rkrajnc/minimig-upstream/README.md

Follows upstream (original) minimig project.
