rkrajnc/minimig-upstream/OTHER/minimig1_layout.pdf

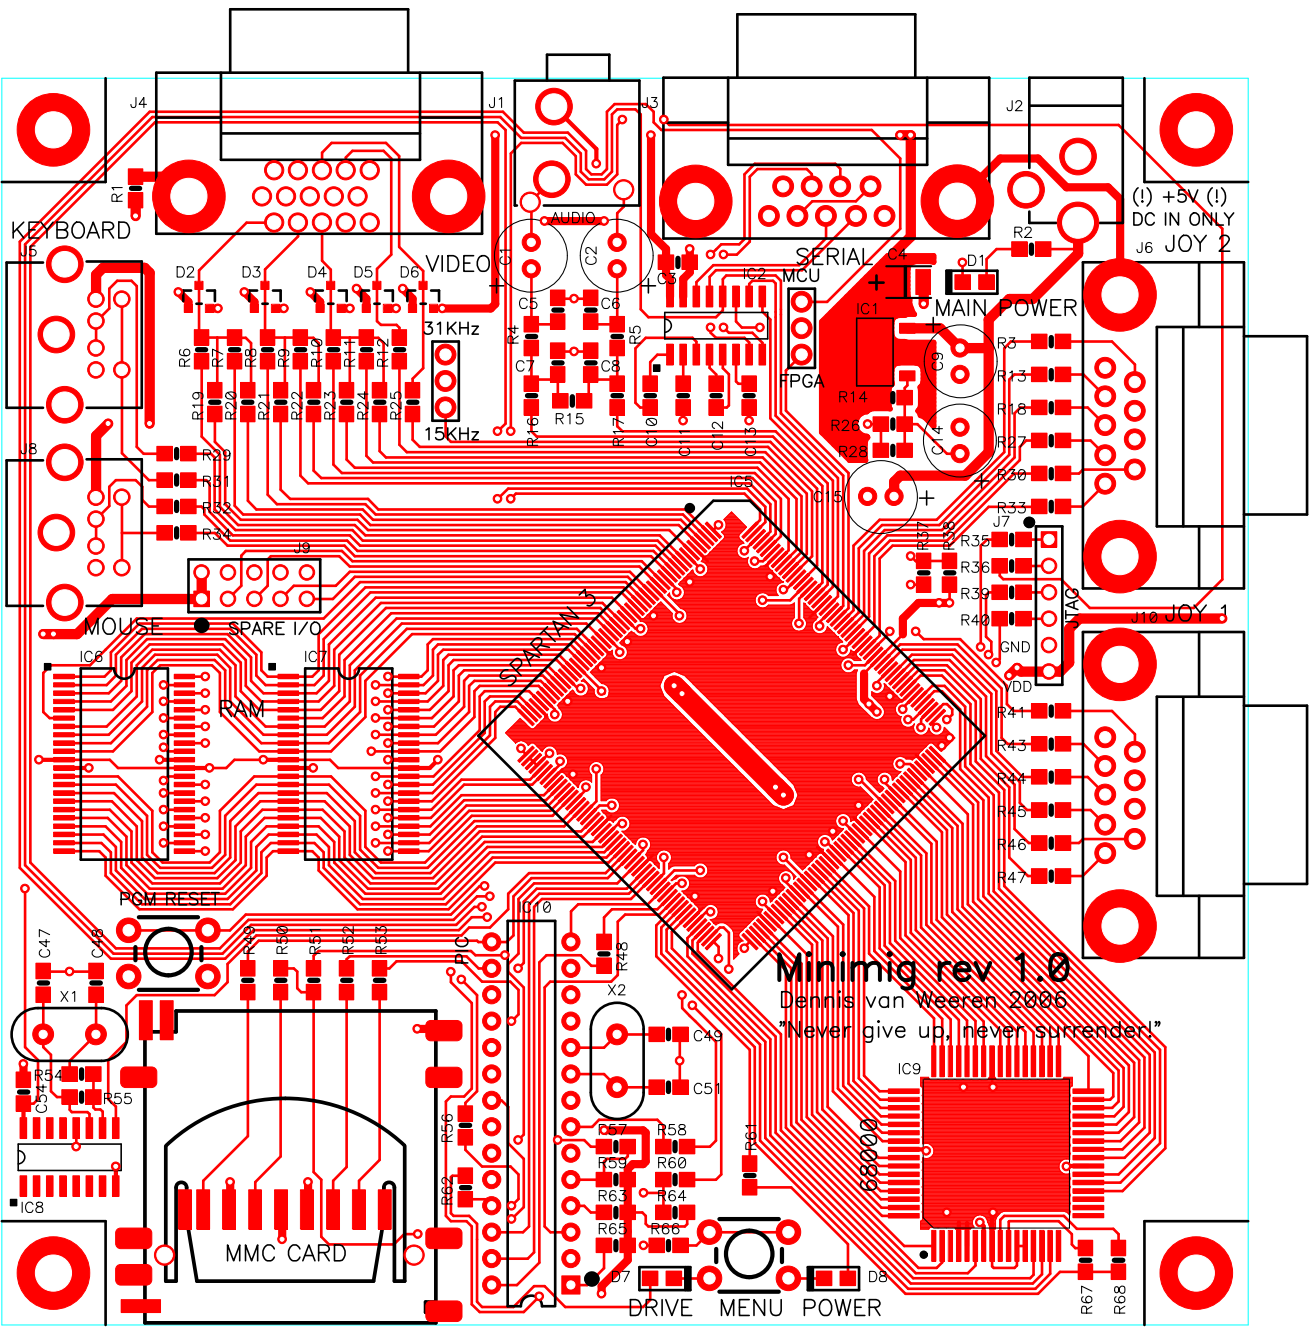
[picture p4: page 1]

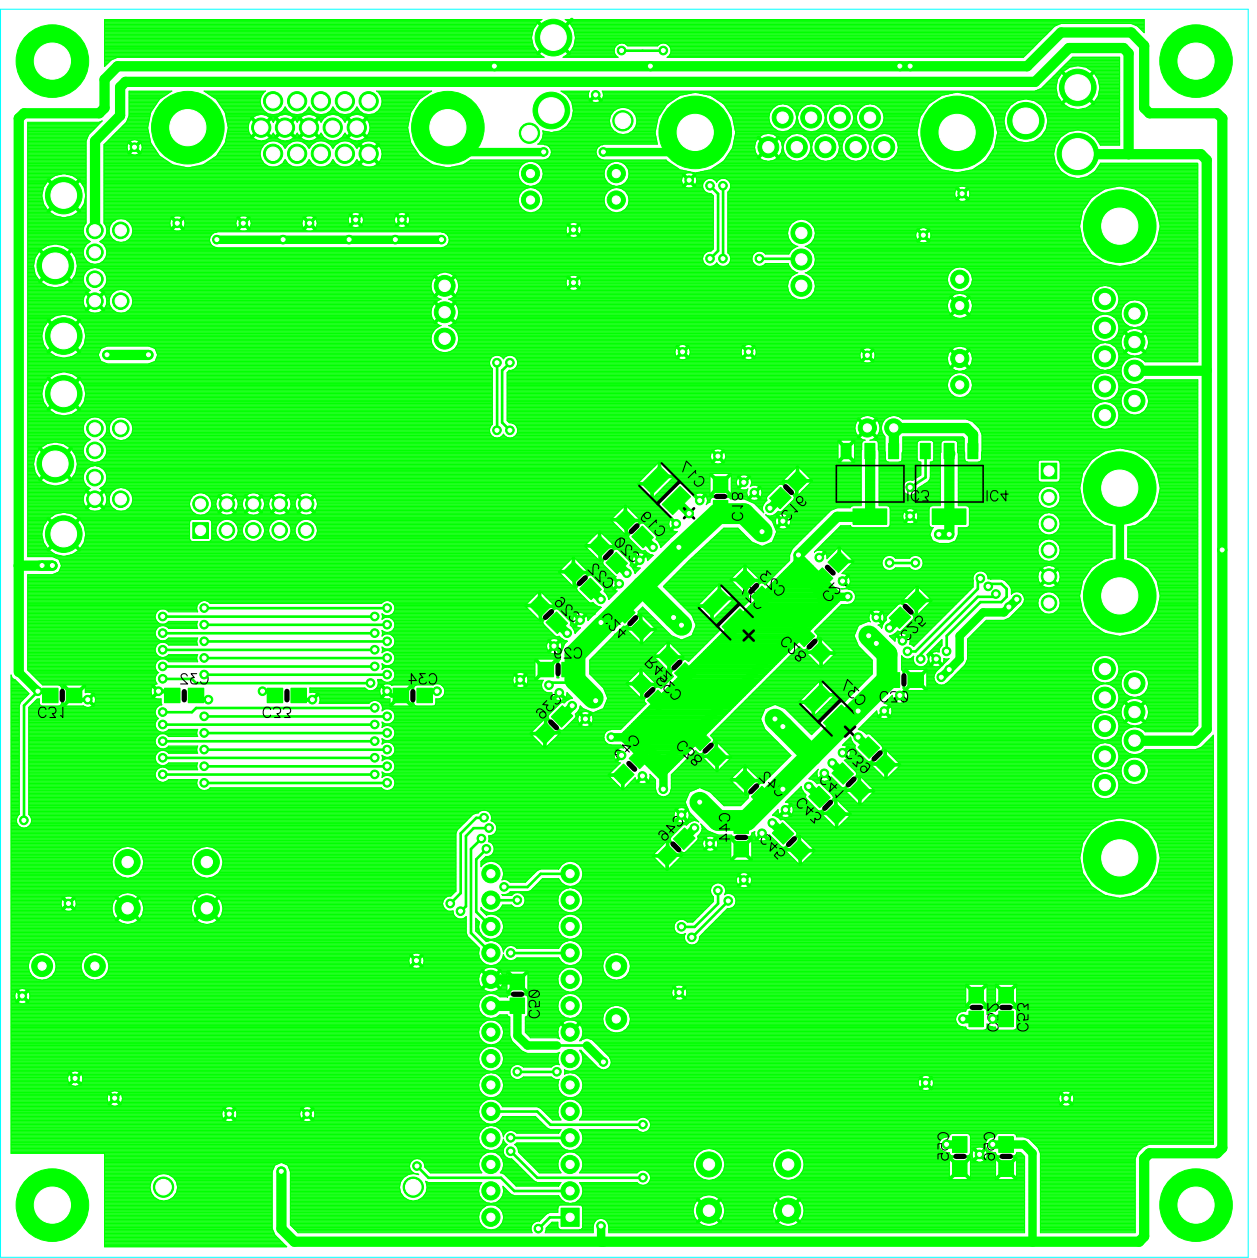
[picture p5: page 2]
