rkrajnc/minimig-upstream/FPGA/Floppy.v

// Copyright 2006, 2007 Dennis van Weeren
//
// This file is part of Minimig
//
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
//
//
// This is the floppy disk controller (part of Paula)
//
// 23-10-2005	-started coding
// 24-10-2005	-done lots of work
// 13-11-2005	-modified fifo to use block ram
//				-done lots of work
// 14-11-2005	-done more work
// 19-11-2005	-added wordsync logic
// 20-11-2005	-finished core floppy disk interface
//				-added disk interrupts
//				-added floppy control signal emulation
// 21-11-2005	-cleaned up code a bit
// 27-11-2005	-den and sden are now active low (_den and _sden)
//				-fixed bug in parallel/serial converter
//				-fixed more bugs
// 02-12-2005	-removed dma abort function
// 04-12-2005	-fixed bug in fifo empty signalling
// 09-12-2005	-fixed dsksync handling	
//				-added protection against stepping beyond track limits
// 10-12-2005	-fixed some more bugs
// 11-12-2005	-added dout output enable to allow SPI bus multiplexing
// 12-12-2005	-fixed major bug, due error in statemachine, multiple interrupts were requested
//				 after a DMA transfer, this could lock up the whole machine
// 				-enable line disconnected  --> this module still needs a lot of work
// 27-12-2005	-cleaned up code, this is it for now
// 07-01-2005	-added dmas
// 15-01-2006	-added support for track 80-127 (used for loading kickstart)
// 22-01-2006	-removed support for track 80-127 again
// 06-02-2006	-added user disk control input
// 28-12-2006	-spi data out is now low when not addressed to allow multiplexing with multiple spi devices		
//
// JB:
// 2008-07-17	- modified floppy interface for better read handling and write support
//				- spi interface clocked by SPI clock
// 2008-09-24	- incompatibility found: _READY signal should respond to _SELx even when the motor is off
//				- added logic for four floppy drives
// 2008-10-07	- ide command request implementation
// 2008-10-28	- further hdd implementation
// 2009-04-05	- code clean-up
// 2009-05-24	- clean-up & renaming
// 2009-07-21	- WORDEQUAL in DSKBYTR register is always set now
// 2009-11-14	- changed DSKSYNC reset value (Kick 1.3 doesn't initialize this register after reset)
//				- reduced FIFO size (to save some block rams)
// 2009-12-26	- step enable
// 2010-04-12	- implemented work-around for dsksync interrupt request
// 2010-08-14	- set BYTEREADY of DSKBYTR (required by Kick Off 2 loader)

module floppy
(
	// system bus interface
	input 	clk,		    		// bus clock
	input 	reset,			   		// reset
	input	ntsc,					// ntsc mode
	input	sof,					// start of frame
	input	enable,					// dma enable
	input 	[8:1] reg_address_in,	// register address inputs
	input	[15:0] data_in,			// bus data in
	output	[15:0] data_out,		// bus data out
	output	dmal,					// dma request output
	output	dmas,					// dma special output 
	// disk control signals from cia and user
	input	_step,					// step heads of disk
	input	direc,					// step heads direction
	input	[3:0] _sel,				// disk select 	
	input	side,					// upper/lower disk head
	input	_motor,					// disk motor control
	output	_track0,				// track zero detect
	output	_change,				// disk has been removed from drive
	output	_ready,					// disk is ready
	output	_wprot,					// disk is write-protected
	output	index,					// disk index pulse
	// interrupt request and misc. control
	output	reg blckint,			// disk dma has finished interrupt
	output	syncint,				// disk syncword found
	input	wordsync,				// wordsync enable
	// flash drive host controller interface	(SPI)
	input	_scs,					// async. serial data enable
	input	sdi,					// async. serial data input
	output	sdo,					// async. serial data output
	input	sck,					// async. serial data clock
	
	output	disk_led,				// disk activity LED, active when DMA is on
	input	[1:0] floppy_drives,	// floppy drive number
	
	input	direct_scs,				// enables direct data transfer from SD card
	input	direct_sdi,				// data line from SD card
	input	hdd_cmd_req,			// HDD requests service (command register has been written)
	input	hdd_dat_req,			// HDD requests data tansfer
	output	[2:0] hdd_addr,			// task file register address
	output	[15:0] hdd_data_out,	// data from HDD to HDC
	input	[15:0] hdd_data_in,		// data from HDC to HDD
	output	hdd_wr,					// task file register write strobe
	output	hdd_status_wr,			// status register write strobe (MCU->HDD)
	output	hdd_data_wr,			// data write strobe
	output	hdd_data_rd				// data read strobe
);

//register names and addresses
	parameter DSKBYTR = 9'h01a;
	parameter DSKDAT  = 9'h026;
	parameter DSKDATR = 9'h008;
	parameter DSKSYNC = 9'h07e;
	parameter DSKLEN  = 9'h024;

	//local signals
	reg		[15:0] dsksync;			//disk sync register
	reg		[15:0] dsklen;			//disk dma length, direction and enable 
	reg		[6:0] dsktrack [3:0];	//track select
	wire	[7:0] track;

	reg		dmaon;					//disk dma read/write enabled
	wire	lenzero;				//disk length counter is zero
	wire	spidat;					//spi data word transfer strobe
	reg		trackwr;				//write track (command to host)
	reg		trackrd;				//read track (command to host)

	wire	_dsktrack0;				//disk heads are over track 0
	wire	dsktrack79;				//disk heads are over track 0

	wire	[15:0] fifo_in;			//fifo data in
	wire	[15:0] fifo_out; 		//fifo data out
	wire	fifo_wr;				//fifo write enable
	reg		fifo_wr_del;			//fifo write enable delayed
	wire	fifo_rd;				//fifo read enable
	wire	fifo_empty;				//fifo is empty
	wire	fifo_full;				//fifo is full
	wire	[11:0] fifo_cnt;

	wire	[15:0] dskbytr;
	wire	[15:0] dskdatr;

	// JB:
	wire	fifo_reset;
	reg		dmaen;					//dsklen dma enable
	reg		[15:0] wr_fifo_status;

	reg		[3:0] disk_present;		//disk present status
	reg		[3:0] disk_writable;	//disk write access status

	wire	_selx;					//active whenever any drive is selected
	wire	[1:0] sel;				//selected drive number

	reg		[1:0] drives;			//number of currently connected floppy drives (1-4)

	reg		[3:0] _disk_change;
	reg		_step_del;
	reg		[8:0] step_ena_cnt;
	wire	step_ena;
	// drive motor control
	reg		[3:0] _sel_del;			// deleyed drive select signals for edge detection
	reg		[3:0] motor_on;			// drive motor on

	//decoded SPI commands
	reg		cmd_fdd;				//SPI host accesses floppy drive buffer
	reg		cmd_hdd_rd;				//SPI host reads task file registers		
	reg		cmd_hdd_wr;				//SPI host writes task file registers
	reg		cmd_hdd_data_wr;		//SPI host writes data to HDD buffer
	reg		cmd_hdd_data_rd;		//SPI host reads data from HDD buffer

//-----------------------------------------------------------------------------------------------//
// JB: SPI interface
//-----------------------------------------------------------------------------------------------//

	wire sdin;					//SPI data in
	wire scs;					//SPI chip select
	wire scs1;
	wire scs2;

	reg [3:0] spi_bit_cnt;		//received bit counter - incremented on rising edge of SCK
	wire spi_bit_15;
	wire spi_bit_0;
	reg [15:1] spi_sdi_reg;		//spi receive register
	reg [15:0] rx_data;			//spi received data
	reg [15:0] spi_sdo_reg;		//spi transmit register (shifted on SCK falling edge)

	reg spi_rx_flag;
	reg rx_flag_sync;
	reg rx_flag;
	wire spi_rx_flag_clr;

	reg spi_tx_flag;
	reg tx_flag_sync;
	reg tx_flag;
	wire spi_tx_flag_clr;

	reg [15:0] spi_tx_data;		//data to be send via SPI
	reg [15:0] spi_tx_data_0;
	reg [15:0] spi_tx_data_1;
	reg [15:0] spi_tx_data_2;
	reg [15:0] spi_tx_data_3;

	reg [1:0] spi_tx_cnt;		//transmitted SPI words counter
	reg [1:0] spi_tx_cnt_del;	//delayed transmitted SPI words counter
	reg [1:0] tx_cnt;			//transmitted SPI words counter
	reg	[2:0] tx_data_cnt;
	reg	[2:0] rx_data_cnt;

	reg	[1:0] rx_cnt;
	reg	[1:0] spi_rx_cnt;		//received SPI words counter (counts form 0 to 3 and stops there)
	reg	spi_rx_cnt_rst;			//indicates reception of the first spi word after activation of the chip select

//SPI mode 0 - high idle clock
assign sdin = direct_scs ? direct_sdi : sdi;
assign scs1 = ~_scs;
assign scs2 = direct_scs;
assign scs = scs1 | scs2;

//received bits counter (0-15)
always @(posedge sck or negedge scs)
	if (~scs)
		spi_bit_cnt <= 0; //reset if chip select is not active
	else
		spi_bit_cnt <= spi_bit_cnt + 1;

assign spi_bit_15 = spi_bit_cnt==15 ? 1 : 0;
assign spi_bit_0 = spi_bit_cnt==0 ? 1 : 0;

//SDI input shift register
always @(posedge sck)
	spi_sdi_reg <= {spi_sdi_reg[14:1],sdin};

//spi rx data register
always @(posedge sck)
	if (spi_bit_15)
		rx_data <= {spi_sdi_reg[15:1],sdin};

// rx_flag is synchronous with clk and is set after receiving the last bit of a word
assign spi_rx_flag_clr = rx_flag | reset;
always @(posedge sck or posedge spi_rx_flag_clr)
	if (spi_rx_flag_clr)
		spi_rx_flag <= 0;
	else if (spi_bit_cnt==15)
		spi_rx_flag <= 1;

always @(negedge clk)
	rx_flag_sync <= spi_rx_flag;	//double synchronization to avoid metastability

always @(posedge clk)
	rx_flag <= rx_flag_sync;		//synchronous with clk

// tx_flag is synchronous with clk and is set after sending the first bit of a word
assign spi_tx_flag_clr = tx_flag | reset;
always @(negedge sck or posedge spi_tx_flag_clr)
	if (spi_tx_flag_clr)
		spi_tx_flag <= 0;
	else if (spi_bit_cnt==0)
		spi_tx_flag <= 1;

always @(negedge clk)
	tx_flag_sync <= spi_tx_flag;	//double synchronization to avoid metastability

always @(posedge clk)
	tx_flag <= tx_flag_sync;		//synchronous with clk

//---------------------------------------------------------------------------------------------------------------------

always @(negedge sck or negedge scs)
	if (~scs)
		spi_tx_cnt <= 0;
	else if (spi_bit_0 && spi_tx_cnt!=3)
		spi_tx_cnt <= spi_tx_cnt + 1;

always @(negedge sck)
	if (spi_bit_0) 
		spi_tx_cnt_del <= spi_tx_cnt;

always @(posedge clk)
	tx_cnt <= spi_tx_cnt_del;

//trnsmitted words counter (0-3) used for transfer of IDE task file registers
always @(negedge sck)
	if (spi_bit_cnt==0)
		if (spi_tx_cnt==2)
			tx_data_cnt <= 0;
		else
			tx_data_cnt <= tx_data_cnt + 1;

//received data counter, used only for transferring IDE task file register contents, count range: 0-7
always @(posedge clk)
	if (rx_flag)
		if (rx_cnt != 3)
			rx_data_cnt <= 0;
		else
			rx_data_cnt <= rx_data_cnt + 1;

//HDD interface
assign hdd_addr = cmd_hdd_rd ? tx_data_cnt : cmd_hdd_wr ? rx_data_cnt : 0;
assign hdd_wr = cmd_hdd_wr && rx_flag && rx_cnt==3 ? 1 : 0;
assign hdd_data_wr = (cmd_hdd_data_wr && rx_flag && rx_cnt==3) || (scs2 && rx_flag) ? 1 : 0;	//there is a possibility that SCS2 is inactive before rx_flag is generated, depends on how fast the CS2 is deaserted after sending the last data bit
assign hdd_status_wr = rx_data[15:12]==4'b1111 && rx_flag && rx_cnt==0 ? 1 : 0;
// problem: spi_cmd1 doesn't deactivate after rising _CS line: direct transfers will be treated as command words,
// workaround: always send more than one command word
assign hdd_data_rd = cmd_hdd_data_rd && tx_flag && tx_cnt==3 ? 1 : 0;
assign hdd_data_out = rx_data[15:0];

always @(posedge sck or negedge scs1)
	if (~scs1)
		spi_rx_cnt_rst <= 1;
	else if (spi_bit_15)
		spi_rx_cnt_rst <= 0;

always @(posedge sck)
	if (scs1 && spi_bit_15)
		if (spi_rx_cnt_rst)
			spi_rx_cnt <= 0;
		else if (spi_rx_cnt!=3)
			spi_rx_cnt <= spi_rx_cnt + 1;

always @(posedge clk)
	rx_cnt <= spi_rx_cnt;

//spidat strobe
assign spidat = cmd_fdd && rx_flag && rx_cnt==3 ? 1 : 0;

//------------------------------------

//SDO output shift register
always @(negedge sck)
	if (spi_bit_cnt==0)
		spi_sdo_reg <= spi_tx_data;
	else
		spi_sdo_reg <= {spi_sdo_reg[14:0],1'b0};

assign sdo = scs1 & spi_sdo_reg[15];

//spi transmit data multiplexer
always @(spi_tx_cnt or spi_tx_data_0 or spi_tx_data_1 or spi_tx_data_2 or spi_tx_data_3)
	case (spi_tx_cnt[1:0])
		0 : spi_tx_data = spi_tx_data_0;
		1 : spi_tx_data = spi_tx_data_1;
		2 : spi_tx_data = spi_tx_data_2;
		3 : spi_tx_data = spi_tx_data_3;
	endcase

always @(sel or drives or hdd_dat_req or hdd_cmd_req or trackwr or trackrd or track or fifo_cnt)
	spi_tx_data_0 = {sel[1:0],drives[1:0],hdd_dat_req,hdd_cmd_req,trackwr,trackrd&~fifo_cnt[10],track[7:0]};

always @(dsksync)
	if (reset)
		spi_tx_data_1 = 0;
	else
		spi_tx_data_1 = dsksync[15:0];

always @(trackrd or dmaen or dsklen or trackwr or wr_fifo_status)
	if (trackrd)
		spi_tx_data_2 = {dmaen,dsklen[14:0]};
	else if (trackwr)
		spi_tx_data_2 = wr_fifo_status;
	else
		spi_tx_data_2 = 0;

always @(cmd_fdd or trackrd or dmaen or dsklen or trackwr or fifo_out or cmd_hdd_rd or cmd_hdd_data_rd or hdd_data_in)	
	if (cmd_fdd)
		if (trackrd)
			spi_tx_data_3 = {dmaen,dsklen[14:0]};
		else if (trackwr)
			spi_tx_data_3 = fifo_out;
		else
			spi_tx_data_3 = 0;
	else if (cmd_hdd_rd || cmd_hdd_data_rd)
		spi_tx_data_3 = hdd_data_in;
	else
		spi_tx_data_3 = 0;


//floppy disk write fifo status is latched when transmision of the previous spi word begins 
//it guarantees that when latching the status data into spi transmit register setup and hold times are met
always @(posedge clk)
	if (tx_flag)
		wr_fifo_status <= {dmaen&dsklen[14],3'b000,fifo_cnt[11:0]};

//-----------------------------------------------------------------------------------------------//
//active floppy drive number, updated during reset
always @(posedge clk)
	if (reset)
		drives <= floppy_drives;

//-----------------------------------------------------------------------------------------------//
// 300 RPM floppy disk rotation signal
reg [3:0] rpm_pulse_cnt;
always @(posedge clk)
	if (sof)
		if (rpm_pulse_cnt==11 || !ntsc && rpm_pulse_cnt==9)
			rpm_pulse_cnt <= 0;
		else
			rpm_pulse_cnt <= rpm_pulse_cnt + 1;

// disk index pulses output
assign index = |(~_sel & motor_on) & ~|rpm_pulse_cnt & sof;

//--------------------------------------------------------------------------------------
//data out multiplexer
assign data_out = dskbytr | dskdatr;

//--------------------------------------------------------------------------------------
//active whenever any drive is selected
assign _selx = &_sel[3:0];

// delayed step signal for detection of its rising edge	
always @(posedge clk)
	_step_del <= _step;

always @(posedge clk)
	if (!step_ena)
		step_ena_cnt <= step_ena_cnt + 1;
	else if (_step && !_step_del)
		step_ena_cnt <= 0;

assign step_ena = step_ena_cnt[8];

// disk change latch
// set by reset or when the disk is removed form the drive
// reset when the disk is present and step pulse is received for selected drive
always @(posedge clk)
	_disk_change <= (_disk_change | ~_sel & {4{_step}} & ~{4{_step_del}} & disk_present) & ~({4{reset}} | ~disk_present);

//active drive number (priority encoder)
assign sel = !_sel[0] ? 0 : !_sel[1] ? 1 : !_sel[2] ? 2 : !_sel[3] ? 3 : 0;

//delayed drive select signals
always @(posedge clk)
	_sel_del <= _sel;

//drive motor control
always @(posedge clk)
	if (reset)
		motor_on[0] <= 1'b0;
	else if (!_sel[0] && _sel_del[0])
		motor_on[0] <= ~_motor;

always @(posedge clk)
	if (reset)
		motor_on[1] <= 1'b0;
	else if (!_sel[1] && _sel_del[1])
		motor_on[1] <= ~_motor;

always @(posedge clk)
	if (reset)
		motor_on[2] <= 1'b0;
	else if (!_sel[2] && _sel_del[2])
		motor_on[2] <= ~_motor;

always @(posedge clk)
	if (reset)
		motor_on[3] <= 1'b0;
	else if (!_sel[3] && _sel_del[3])
		motor_on[3] <= ~_motor;

//_ready,_track0 and _change signals
assign _change = &(_sel | _disk_change);

assign _wprot = &(_sel | disk_writable);

assign  _track0 = &(_selx | _dsktrack0);

//track control
assign track = {dsktrack[sel],~side};

always @(posedge clk)
	if (!_selx && _step && !_step_del && step_ena) // track increment (direc=0) or decrement (direc=1) at rising edge of _step
		if (!dsktrack79 && !direc)
			dsktrack[sel] <= dsktrack[sel] + 1;
		else if (_dsktrack0 && direc)
			dsktrack[sel] <= dsktrack[sel] - 1;

// _dsktrack0 detect
assign _dsktrack0 = dsktrack[sel]==0 ? 0 : 1;

// dsktrack79 detect
assign dsktrack79 = dsktrack[sel]==82 ? 1 : 0;

// drive _ready signal control
// Amiga DD drive activates _ready whenever _sel is active and motor is off
// or whenever _sel is active, motor is on and there is a disk inserted (not implemented - _ready is active when _sel is active)

assign _ready 	= (_sel[3] | ~(drives[1] & drives[0])) 
				& (_sel[2] | ~drives[1]) 
				& (_sel[1] | ~(drives[1] | drives[0])) 
				& (_sel[0]);

//--------------------------------------------------------------------------------------

//disk data byte and status read
assign dskbytr = reg_address_in[8:1]==DSKBYTR[8:1] ? {1'b1,(trackrd|trackwr),dsklen[14],5'b1_0000,8'h00} : 16'h00_00;

//disk sync register
always @(posedge clk)
	if (reset)
		dsksync[15:0] <= 16'h4489;
	else if (reg_address_in[8:1]==DSKSYNC[8:1])
		dsksync[15:0] <= data_in[15:0];

//disk length register
always @(posedge clk)
	if (reset)
		dsklen[14:0] <= 0;
	else if (reg_address_in[8:1]==DSKLEN[8:1])
		dsklen[14:0] <= data_in[14:0];
	else if (fifo_wr)//decrement length register
		dsklen[13:0] <= dsklen[13:0] - 1;

//disk length register DMAEN
always @(posedge clk)
	if (reset)
		dsklen[15] <= 0;
	else if (blckint)
		dsklen[15] <= 0;
	else if (reg_address_in[8:1]==DSKLEN[8:1])
		dsklen[15] <= data_in[15];

//dmaen - disk dma enable signal
always @(posedge clk)
	if (reset)
		dmaen <= 0;
	else if (blckint)
		dmaen <= 0;
	else if (reg_address_in[8:1]==DSKLEN[8:1])
		dmaen <= data_in[15] & dsklen[15];//start disk dma if second write in a row with dsklen[15] set

//dsklen zero detect
assign lenzero = (dsklen[13:0]==0) ? 1 : 0;

//--------------------------------------------------------------------------------------
//disk data read path
wire	busrd;				//bus read
wire	buswr;				//bus write
reg		trackrdok;			//track read enable

//disk buffer bus read address decode
assign busrd = (reg_address_in[8:1]==DSKDATR[8:1]) ? 1 : 0;

//disk buffer bus write address decode
assign buswr = (reg_address_in[8:1]==DSKDAT[8:1]) ? 1 : 0;

//fifo data input multiplexer
assign fifo_in[15:0] = trackrd ? rx_data[15:0] : data_in[15:0];

//fifo write control
assign fifo_wr = (trackrdok & spidat & ~lenzero) | (buswr & dmaon);

//delayed version to allow writing of the last word to empty fifo
always @(posedge clk)
	fifo_wr_del <= fifo_wr;

//fifo read control
assign fifo_rd = (busrd & dmaon) | (trackwr & spidat);

//DSKSYNC interrupt
wire sync_match;
assign sync_match = dsksync[15:0]==rx_data[15:0] && spidat && trackrd ? 1'b1 : 1'b0;

assign syncint = sync_match | ~dmaen & |(~_sel & motor_on & disk_present) & sof;

//track read enable / wait for syncword logic
always @(posedge clk)
	if (!trackrd)//reset
		trackrdok <= 0;
	else//wordsync is enabled, wait with reading untill syncword is found
		trackrdok <= ~wordsync | sync_match | trackrdok;

assign fifo_reset = reset | ~dmaen;

//disk fifo / trackbuffer
fifo db1
(
	.clk(clk),
	.reset(fifo_reset),
	.in(fifo_in),
	.out(fifo_out),
	.rd(fifo_rd & ~fifo_empty),
	.wr(fifo_wr & ~fifo_full),
	.empty(fifo_empty),
	.full(fifo_full),
	.cnt(fifo_cnt)
);


//disk data read output gate
assign dskdatr[15:0] = busrd ? fifo_out[15:0] : 16'h00_00;

//--------------------------------------------------------------------------------------
//dma request logic
assign dmal = dmaon & (~dsklen[14] & ~fifo_empty | dsklen[14] & ~fifo_full);
//dmas is active during writes
assign dmas = dmaon & dsklen[14] & ~fifo_full;

//--------------------------------------------------------------------------------------
//main disk controller
reg		[1:0] dskstate;		//current state of disk
reg		[1:0] nextstate; 	//next state of state

//disk states
parameter DISKDMA_IDLE   = 2'b00;
parameter DISKDMA_ACTIVE = 2'b10;
parameter DISKDMA_INT    = 2'b11;

//disk present and write protect status
always @(posedge clk)
	if(reset)
		{disk_writable[3:0],disk_present[3:0]} <= 8'b0000_0000;
	else if (rx_data[15:12]==4'b0001 && rx_flag && rx_cnt==0)
		{disk_writable[3:0],disk_present[3:0]} <= rx_data[7:0];

always @(posedge clk)
	if (reset)
	begin
		cmd_fdd <= 0;
		cmd_hdd_rd <= 0;
		cmd_hdd_wr <= 0;
		cmd_hdd_data_wr <= 0;
		cmd_hdd_data_rd <= 0;
	end
	else if (rx_flag && rx_cnt==0)
	begin
		cmd_fdd <= rx_data[15:13]==3'b000 ? 1 : 0;
		cmd_hdd_rd <= rx_data[15:12]==4'b1000 ? 1 : 0;
		cmd_hdd_wr <= rx_data[15:12]==4'b1001 ? 1 : 0;
		cmd_hdd_data_wr <= rx_data[15:12]==4'b1010 ? 1 : 0;
		cmd_hdd_data_rd <= rx_data[15:12]==4'b1011 ? 1 : 0;
	end

//disk activity LED
//assign disk_led = dskstate!=DISKDMA_IDLE ? 1'b1 : 1'b0;
assign disk_led = |motor_on;

//main disk state machine
always @(posedge clk)
	if (reset)
		dskstate <= DISKDMA_IDLE;
	else
		dskstate <= nextstate;

always @(dskstate or spidat or rx_data or dmaen or lenzero or enable or dsklen or fifo_empty or rx_flag or cmd_fdd or rx_cnt or fifo_wr_del)
begin
	case(dskstate)
		DISKDMA_IDLE://disk is present in flash drive
		begin
			trackrd = 0;
			trackwr = 0;
			dmaon = 0;
			blckint = 0;
			if (cmd_fdd && rx_flag && rx_cnt==1 && dmaen && !lenzero && enable)//dsklen>0 and dma enabled, do disk dma operation
				nextstate = DISKDMA_ACTIVE; 
			else
				nextstate = DISKDMA_IDLE;
		end
		DISKDMA_ACTIVE://do disk dma operation
		begin
			trackrd = ~lenzero & ~dsklen[14]; // track read (disk->ram)
			trackwr = dsklen[14]; // track write (ram->disk)
			dmaon = ~lenzero | ~dsklen[14];
			blckint=0;
			if (!dmaen || !enable)
				nextstate = DISKDMA_IDLE;
			else if (lenzero && fifo_empty && !fifo_wr_del)//complete dma cycle done
				nextstate = DISKDMA_INT;
			else
				nextstate = DISKDMA_ACTIVE;
		end
		DISKDMA_INT://generate disk dma completed (DSKBLK) interrupt
		begin
			trackrd = 0;
			trackwr = 0;
			dmaon = 0;
			blckint = 1;
			nextstate = DISKDMA_IDLE;
		end
		default://we should never come here
		begin
			trackrd = 1'bx;
			trackwr = 1'bx;
			dmaon = 1'bx;
			blckint = 1'bx;
			nextstate = DISKDMA_IDLE;
		end
	endcase
end


//--------------------------------------------------------------------------------------

endmodule

//--------------------------------------------------------------------------------------
// 2048x16 FIFO
module fifo
(
	input 	clk,		    	// bus clock
	input 	reset,			   	// reset
	input	[15:0] in,			// data in
	output	reg [15:0] out,		// data out
	input	rd,					// read from fifo
	input	wr,					// write to fifo
	output	reg empty,			// fifo is empty
	output	full,				// fifo is full
	output	[11:0] cnt			// number of entries in FIFO
);

//local signals and registers
reg 	[15:0] mem [2047:0];	// 2048 words by 16 bit wide fifo memory (for 2 MFM-encoded sectors)
reg		[11:0] in_ptr;			// fifo input pointer
reg		[11:0] out_ptr;			// fifo output pointer
wire	equal;					// lower 11 bits of in_ptr and out_ptr are equal

// count of FIFO entries
assign cnt = in_ptr - out_ptr;

// main fifo memory (implemented using synchronous block ram)
always @(posedge clk)
	if (wr)
		mem[in_ptr[10:0]] <= in;

always @(posedge clk)
	out = mem[out_ptr[10:0]];

// fifo write pointer control
always @(posedge clk)
	if (reset)
		in_ptr[11:0] <= 0;
	else if (wr)
		in_ptr[11:0] <= in_ptr[11:0] + 1;

// fifo read pointer control
always @(posedge clk)
	if (reset)
		out_ptr[11:0] <= 0;
	else if (rd)
		out_ptr[11:0] <= out_ptr[11:0] + 1;

// check lower 11 bits of pointer to generate equal signal
assign equal = in_ptr[10:0]==out_ptr[10:0] ? 1'b1 : 1'b0;

// assign output flags, empty is delayed by one clock to handle ram delay
always @(posedge clk)
	if (equal && in_ptr[11]==out_ptr[11])
		empty <= 1'b1;
	else
		empty <= 1'b0;

assign full = equal && in_ptr[11]!=out_ptr[11] ? 1'b1 : 1'b0;

endmodule
