rkrajnc/minimig-upstream/FPGA/ActionReplay3.v

// Copyright 2008, 2009 by Jakub Bednarski
// 
// This file is part of Minimig
// 
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
// 
// 
// JB:
// This module is based on information from WinUAE code (ar.c), the internet (How to Code the Amiga) 
// and examination of Action Replay code.
// You need Action Replay rom file (named "AR3.ROM").
// The bootloader loads this file at $400000-43ffff (256KB).
// If bootloader writes to that location it enables Action Replay. 
// It also takes one 512KB RAM bank so max. 1MB for Amiga RAM is left.
// Tested with Action Replay III rom version 3.17. 
// This ROM only works with kickstart 1.3 and 2.04 (37.175).
// 
// Custom register shadow memory ($44f000-$44f1ff) contains all actual values, not only those written by the CPU.
// 
// Freeze button is Ctrl+Break.
// 
// Breeakpoints don't work entirely as they should:
// when breakpoint is triggered, immediate exit with "x" command doesn't arm breakpoint circuit,
// doing a step trace ("tr" command) and then exit works ok: consecutive breakpoint triggers.
// 
// 
// 2008-03-25	- first version, INT7 freeze button
// 2008-03-26	- loading of ROM @ $400000
// 2008-03-27	- mode register, ram overlay and INT7 on reset
// 2008-03-28	- custom register shadow
// 2008-03-29	- custom register shadow written from RGA bus
// 2008-03-30	- mem watch breakpoint circuit 
// 2008-04-11	- AR style breakpoint circuit 
// 2008-07-10	- added disabling of AR when no ROM was uploaded
// 2008-07-17	- code clean up
// 2008-07-28	- code clean up
// 2008-10-07	- improvements for 28MHz CPU
// 2009-05-24	- clean-up & renaming
// 2009-08-16	- reg_data_in port added (thanks Sascha)
// 2009-12-18	- code cleaned up
// 2010-07-26	- code cleaned up
// 2010-08-15	- int7 generation when no cartridge ROM loaded

module ActionReplay
(
	input	clk,
	input	reset,
	input	[23:1] cpu_address,
	input	[23:1] cpu_address_in,
	input	cpu_clk,
	input	_cpu_as,
	input	[8:1] reg_address_in,
	input	[15:0] reg_data_in,
	input	[15:0] data_in,
	output	[15:0] data_out,
	input	cpu_rd,
	input	cpu_hwr,
	input	cpu_lwr,
	input	dbr,
	input	boot,
	output	ovr,
	input	freeze,
	output	reg int7,
	output	selmem,
	output	reg aron = 1'b0
);

reg		freeze_del;
wire	freeze_req;
wire	int7_req;
wire	int7_ack;
reg		l_int7_req;
reg		l_int7_ack;
reg		l_int7;
wire	reset_req;
wire	break_req;
reg		after_reset;
reg		[1:0] mode;
reg		[1:0] status;
reg		ram_ovl;	// override chip memory and show its rom for int7 vector
reg		active;		// cartridge is active (rom is visible)

wire	sel_cart;	// select cartridge cpu space ($400000-$47ffff)
wire	sel_rom;	// select rom space ($400004-$43ffff)
wire	sel_ram;	// select ram space ($440000-$47ffff) - ($44F000-$44F1FF)
wire 	sel_custom;	// select custom register shadow ($44F000-$44F1FF)
wire	sel_status;	// status register $400000-$400003 (repeated twice)
wire	sel_mode;	// mode register $400000/1

// output signals
wire	[15:0] custom_out;
wire	[15:0] status_out;

// -------------------------------------------------------------------------------------------------

// see above
assign sel_cart = aron & ~dbr & (cpu_address_in[23:19]==5'b0100_0);
assign sel_rom = sel_cart & ~cpu_address_in[18] & |cpu_address_in[17:2];
assign sel_ram = sel_cart & cpu_address_in[18] & (cpu_address_in[17:9]!=9'b001111_000);
assign sel_custom = sel_cart & cpu_address_in[18] & (cpu_address_in[17:9]==9'b001111_000) & cpu_rd;
assign sel_mode = sel_cart & ~|cpu_address_in[18:1];
assign sel_status = sel_cart & ~|cpu_address_in[18:2] & cpu_rd;
assign sel_ovl = ram_ovl & (cpu_address_in[23:19]==5'b0000_0) & cpu_rd;
assign selmem = (sel_rom & boot) | ((sel_rom & cpu_rd) | sel_ram | sel_ovl);

// Action Replay is activated by writing to its ROM area during bootloading
always @(posedge clk)
	if (!reset && boot && cpu_address_in[23:18]==6'b0100_00 && cpu_lwr)
		aron <= 1'b1;	// rom will miss first write but since 2 first words of rom are not readable it doesn't matter

// delayed signal for edge dettection
always @(posedge clk)
	freeze_del <= freeze;

// freeze button has been pressed
assign freeze_req = freeze & ~freeze_del & (~active | ~aron);

// int7 request
assign int7_req = ~boot & aron & (freeze_req | reset_req | break_req);

// level7 interrupt ack cycle, on Amiga interrupt vector number is read from kickstart rom
// A[23:4] all high, A[3:1] vector number
assign int7_ack = &cpu_address & ~_cpu_as;

// level 7 interrupt request logic
// interrupt request lines are sampled during S4->S5 transition (falling cpu clock edge)
always @(posedge cpu_clk)
	if (reset)
		int7 <= 1'b0;
	else if (int7_req)
		int7 <= 1'b1;
	else if (int7_ack)
		int7 <= 1'b0;
		
always @(posedge clk)
	l_int7_req <= int7_req;

always @(posedge clk)
	l_int7_ack <= int7_ack;

always @(posedge clk)
	if (reset)
		l_int7 <= 1'b0;
	else if (l_int7_req)
		l_int7 <= 1'b1;
	else if (l_int7_ack && cpu_rd)
		l_int7 <= 1'b0;
		
// triggers int7 when first CPU write after reset to memory location $8
// AR rom checks if PC==$FC0144 or $F80160, other kickstarts need to path these values
// _IPLx lines are sampled durring S4->S5 transition, _cpu_as is asserted during S2, 
// if we assert _IPLx lines too late the AR rom code won't properly recognize this request
assign reset_req = aron && cpu_address[23:1]==23'h04 && !_cpu_as && after_reset ? 1'b1 : 1'b0;

// set after reset, cleared by first INT7 req
always @(posedge cpu_clk)
	if (reset)
		after_reset <= 1'b1;
	else if (int7_ack)
		after_reset <= 1'b0;

// chip ram overlay, when INT7 is active AR rom apears in chipram area
// cleared by write to $400006
always @(posedge clk)
	if (reset)
		ram_ovl <= 1'b0;
	else if (l_int7 && l_int7_ack && cpu_rd) // once again we don't know the state of CPU's FCx signals
		ram_ovl <= 1'b1;
	else if (sel_rom && (cpu_address_in[2:1]==2'b11) && (cpu_hwr|cpu_lwr))
		ram_ovl <= 1'b0;

// when INT7 is activated AR's rom and ram apear in its address space ($400000-$47FFFF)
// this flag is cleared by write to $400000 (see code at  $4013DA)
// since we miss CPU's FC signals we cannot distinguish data and code access
// so we don't hide AR's rom and ram
always @(posedge clk)
	if (reset)
		active <= 1'b0;
	else if (l_int7 && l_int7_ack && cpu_rd)// once again we don't know the state of CPU's FC signals
		active <= 1'b1;
	else if (sel_mode && (cpu_address_in[2:1]==2'b00) && (cpu_hwr|cpu_lwr))
		active <= 1'b0;

// override chipram decoding (externally gated with rd)
assign ovr = ram_ovl;

//===============================================================================================// 

// setting mode[1] enables breakpoint circuity
// don't know yet why but exiting immediately from breakpoint with 'x' command doesn't enable brekpoints (mode=0)
// preceeding 'x' with 'tr' works ok
always @(posedge clk)
	if (reset)
		mode <= 2'b11;
	else if (sel_mode && cpu_lwr)	// cpu write to mode register
		mode <= data_in[1:0];

always @(posedge clk)
	if (reset)
		status <= 2'b11;
	else if (freeze_req)			// freeze button pressed
		status <= 2'b00;
	else if (break_req)			// breakpoint raised
		status <= 2'b01;

assign status_out = sel_status ? {14'h00,status} : 16'h00_00;


//===============================================================================================// 
// custom registers shadow memory - all writes by cpu and dma are reflected
reg		[15:0] custom [255:0];
reg		[8:1] custom_adr;

// use clocked address to infer blockram
always @(negedge clk)
	custom_adr[8:1] <= cpu_address_in[8:1];

// custom registers shadow buffer write
always @(posedge clk)
	custom[reg_address_in] <= reg_data_in;

// custom registers shadow buffer read
assign custom_out = sel_custom ? custom[custom_adr[8:1]] : 16'h00_00;

//===============================================================================================// 

// data_out multiplexer
assign data_out = custom_out | status_out;

//===============================================================================================// 

//===============================================================================================// 
// /TRACE:
// 150: 4A39 00BF E001   TST.B BFE001
// 156: 60F8             BRA   150
// BREAKPOINT:
// 040: 4A39 00BF E001   TST.B BFE001
// 046: 60F8             BRA   040
// MEMWATCH:
// 130: 4A39 00BF E001   TST.B BFE001
// 136: 4E71             NOP
// 138: 4E71             NOP

// Action Replay is activated when memory at address $BFE001 is accessed from $000-$400

reg	cpu_address_hit;

// address range access $000-$3FF		
always @(posedge _cpu_as)
	cpu_address_hit <= cpu_address[23:10]==14'h00 ? 1'b1 : 1'b0;

// access of $BFE001 from $000-$3FF memory range
assign break_req = ~active && aron && mode[1] && cpu_address_hit && cpu_address==(24'hBFE001>>1) && !_cpu_as ? 1'b1 : 1'b0;

endmodule
