rkrajnc/minimig-upstream/FPGA/BootRom.v

// Copyright 2006, 2007 Dennis van Weeren
//
// This file is part of Minimig
//
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
//
//
// This is the Minimig boot rom
// The bootrom contains code for early startup of the Minimig.
// The bootrom will download the kickstart rom image trough the floppy 
// interface to the kickstart ram area. 
//
// 11-04-2005	- removed rd signal because it is no longer necessary
// 19-04-2005	- expanded to 2Kbyte address space
// 21-12-2005	- added rd input
// 27-11-2006	- rom now implemented using blockram
// ----------
//
// JB:
// 2008-05-14	- Verilog 2001 style module definition
// 2008-05-14	- new bootloader
// 2008-09-27	- FPGA core version updated & code clean-up
// 2009-05-24	- clean-up & renaming
// 2009-06-06	- adapted bootloader for firmware with high resolution OSD display
// 2009-09-11	- updated bootloader code
// 2009-12-17	- updated bootloader code
// 2009-12-24	- updated version number
// 2010-06-03	- updated version number
// 2010-07-28	- updated version number
// 2010-08-18	- updated version number
 
module bootrom
(
	input 	clk,					// bus clock
	input 	aen,    				// rom enable
	input	rd,						// bus read
	input 	[10:1] address_in,		// address in
	output 	reg [15:0] data_out		// data out
);

reg	 	[10:1] romaddress;
reg		[15:0] romdata;

// use clocked address to infer blockram
always @(negedge clk)
	romaddress[10:1] <= address_in[10:1];

// the rom itself
// FPGA core version is stored in words 4-7 as 8 ASCII characters 
// bytes:
// 0-1: vendor id (YQ for JB :-)
// 2-3: year
// 4-5: month
// 6-7: day

// if all goes well this rom will be implemented using blockram
always @(romaddress)
begin
	case (romaddress)
		0000:	romdata[15:0] = 16'h0001;
		0001:	romdata[15:0] = 16'h0000;
		0002:	romdata[15:0] = 16'h0000;
		0003:	romdata[15:0] = 16'h0010;
		0004:	romdata[15:0] = 16'h5342; // fpga version - $5342 = SB
		0005:	romdata[15:0] = 16'h3135; // year
		0006:	romdata[15:0] = 16'h3035; // month
		0007:	romdata[15:0] = 16'h3230; // day
		0008:	romdata[15:0] = 16'h4DF9;
		0009:	romdata[15:0] = 16'h00DF;
		0010:	romdata[15:0] = 16'hF000;
		0011:	romdata[15:0] = 16'h6100;
		0012:	romdata[15:0] = 16'h0346;
		0013:	romdata[15:0] = 16'h3D7C;
		0014:	romdata[15:0] = 16'h9000;
		0015:	romdata[15:0] = 16'h0100;
		0016:	romdata[15:0] = 16'h3D7C;
		0017:	romdata[15:0] = 16'h0000;
		0018:	romdata[15:0] = 16'h0102;
		0019:	romdata[15:0] = 16'h3D7C;
		0020:	romdata[15:0] = 16'h0000;
		0021:	romdata[15:0] = 16'h0104;
		0022:	romdata[15:0] = 16'h3D7C;
		0023:	romdata[15:0] = 16'h0000;
		0024:	romdata[15:0] = 16'h0108;
		0025:	romdata[15:0] = 16'h3D7C;
		0026:	romdata[15:0] = 16'h0000;
		0027:	romdata[15:0] = 16'h010A;
		0028:	romdata[15:0] = 16'h3D7C;
		0029:	romdata[15:0] = 16'h003C;
		0030:	romdata[15:0] = 16'h0092;
		0031:	romdata[15:0] = 16'h3D7C;
		0032:	romdata[15:0] = 16'h00D4;
		0033:	romdata[15:0] = 16'h0094;
		0034:	romdata[15:0] = 16'h3D7C;
		0035:	romdata[15:0] = 16'h2C81;
		0036:	romdata[15:0] = 16'h008E;
		0037:	romdata[15:0] = 16'h3D7C;
		0038:	romdata[15:0] = 16'hF4C1;
		0039:	romdata[15:0] = 16'h0090;
		0040:	romdata[15:0] = 16'h3D7C;
		0041:	romdata[15:0] = 16'h0008;	// background color
		0042:	romdata[15:0] = 16'h0180;
		0043:	romdata[15:0] = 16'h3D7C;
		0044:	romdata[15:0] = 16'h0FFF;	// text color
		0045:	romdata[15:0] = 16'h0182;
		0046:	romdata[15:0] = 16'h41F9;
		0047:	romdata[15:0] = 16'h0000;
		0048:	romdata[15:0] = 16'h0378;
		0049:	romdata[15:0] = 16'h43F9;
		0050:	romdata[15:0] = 16'h0000;
		0051:	romdata[15:0] = 16'hC100;
		0052:	romdata[15:0] = 16'h7002;
		0053:	romdata[15:0] = 16'h22D8;
		0054:	romdata[15:0] = 16'h51C8;
		0055:	romdata[15:0] = 16'hFFFC;
		0056:	romdata[15:0] = 16'h2D7C;
		0057:	romdata[15:0] = 16'h0000;
		0058:	romdata[15:0] = 16'hC100;
		0059:	romdata[15:0] = 16'h0080;
		0060:	romdata[15:0] = 16'h3D40;
		0061:	romdata[15:0] = 16'h0088;
		0062:	romdata[15:0] = 16'h3D7C;
		0063:	romdata[15:0] = 16'h8390;
		0064:	romdata[15:0] = 16'h0096;
		0065:	romdata[15:0] = 16'h3D7C;
		0066:	romdata[15:0] = 16'h7FFF;
		0067:	romdata[15:0] = 16'h009E;
		0068:	romdata[15:0] = 16'h41F9;
		0069:	romdata[15:0] = 16'h0000;
		0070:	romdata[15:0] = 16'h0384;
		0071:	romdata[15:0] = 16'h6100;
		0072:	romdata[15:0] = 16'h02A8;
		0073:	romdata[15:0] = 16'h41F9;
		0074:	romdata[15:0] = 16'h0000;
		0075:	romdata[15:0] = 16'h0409;
		0076:	romdata[15:0] = 16'h6100;
		0077:	romdata[15:0] = 16'h029E;
		0078:	romdata[15:0] = 16'h41F9;
		0079:	romdata[15:0] = 16'h0000;
		0080:	romdata[15:0] = 16'h0420;
		0081:	romdata[15:0] = 16'h6100;
		0082:	romdata[15:0] = 16'h0294;
		0083:	romdata[15:0] = 16'h45F9;
		0084:	romdata[15:0] = 16'h0000;
		0085:	romdata[15:0] = 16'h0008;
		0086:	romdata[15:0] = 16'h7E07;
		0087:	romdata[15:0] = 16'h101A;
		0088:	romdata[15:0] = 16'h6100;
		0089:	romdata[15:0] = 16'h0232;
		0090:	romdata[15:0] = 16'h51CF;
		0091:	romdata[15:0] = 16'hFFF8;
		0092:	romdata[15:0] = 16'h41F9;
		0093:	romdata[15:0] = 16'h0000;
		0094:	romdata[15:0] = 16'h042D;
		0095:	romdata[15:0] = 16'h6100;
		0096:	romdata[15:0] = 16'h0278;
		0097:	romdata[15:0] = 16'h302E;
		0098:	romdata[15:0] = 16'h0004;
		0099:	romdata[15:0] = 16'hE048;
		0100:	romdata[15:0] = 16'h0200;
		0101:	romdata[15:0] = 16'h007F;
		0102:	romdata[15:0] = 16'h6100;
		0103:	romdata[15:0] = 16'h01F8;
		0104:	romdata[15:0] = 16'h41F9;
		0105:	romdata[15:0] = 16'h0000;
		0106:	romdata[15:0] = 16'h043B;
		0107:	romdata[15:0] = 16'h0801;
		0108:	romdata[15:0] = 16'h0004;
		0109:	romdata[15:0] = 16'h6700;
		0110:	romdata[15:0] = 16'h0008;
		0111:	romdata[15:0] = 16'h41F9;
		0112:	romdata[15:0] = 16'h0000;
		0113:	romdata[15:0] = 16'h0442;
		0114:	romdata[15:0] = 16'h6100;
		0115:	romdata[15:0] = 16'h0252;
		0116:	romdata[15:0] = 16'h41F9;
		0117:	romdata[15:0] = 16'h0000;
		0118:	romdata[15:0] = 16'h044A;
		0119:	romdata[15:0] = 16'h6100;
		0120:	romdata[15:0] = 16'h0248;
		0121:	romdata[15:0] = 16'h302E;
		0122:	romdata[15:0] = 16'h007C;
		0123:	romdata[15:0] = 16'h6100;
		0124:	romdata[15:0] = 16'h01CE;
		0125:	romdata[15:0] = 16'h700A;
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
		0250:	romdata[15:0] = 16'hFFD0;
		0251:	romdata[15:0] = 16'hBBFC;
		0252:	romdata[15:0] = 16'h00F8;
		0253:	romdata[15:0] = 16'h0000;
		0254:	romdata[15:0] = 16'h6600;
		0255:	romdata[15:0] = 16'h0018;
		0256:	romdata[15:0] = 16'h0C85;
		0257:	romdata[15:0] = 16'h0004;
		0258:	romdata[15:0] = 16'h0000;
		0259:	romdata[15:0] = 16'h6600;
		0260:	romdata[15:0] = 16'h000E;
		0261:	romdata[15:0] = 16'h284D;
		0262:	romdata[15:0] = 16'hD9C5;
		0263:	romdata[15:0] = 16'h7AFF;
		0264:	romdata[15:0] = 16'h28DD;
		0265:	romdata[15:0] = 16'h51CD;
		0266:	romdata[15:0] = 16'hFFFC;
		0267:	romdata[15:0] = 16'h700A;
		0268:	romdata[15:0] = 16'h6100;
		0269:	romdata[15:0] = 16'h00CA;
		0270:	romdata[15:0] = 16'h6000;
		0271:	romdata[15:0] = 16'h0064;
		0272:	romdata[15:0] = 16'h0C40;
		0273:	romdata[15:0] = 16'h0003;
		0274:	romdata[15:0] = 16'h6600;
		0275:	romdata[15:0] = 16'h0012;
		0276:	romdata[15:0] = 16'h08F9;
		0277:	romdata[15:0] = 16'h0001;
		0278:	romdata[15:0] = 16'h00BF;
		0279:	romdata[15:0] = 16'hE001;
		0280:	romdata[15:0] = 16'h4A39;
		0281:	romdata[15:0] = 16'h00BF;
		0282:	romdata[15:0] = 16'hC000;
		0283:	romdata[15:0] = 16'h60FE;
		0284:	romdata[15:0] = 16'h0C40;
		0285:	romdata[15:0] = 16'h0004;
		0286:	romdata[15:0] = 16'h6600;
		0287:	romdata[15:0] = 16'h0014;
		0288:	romdata[15:0] = 16'h2858;
		0289:	romdata[15:0] = 16'h2818;
		0290:	romdata[15:0] = 16'h7000;
		0291:	romdata[15:0] = 16'h28C0;
		0292:	romdata[15:0] = 16'h5984;
		0293:	romdata[15:0] = 16'h6E00;
		0294:	romdata[15:0] = 16'hFFFA;
		0295:	romdata[15:0] = 16'h6000;
		0296:	romdata[15:0] = 16'h0032;
		0297:	romdata[15:0] = 16'h3E00;
		0298:	romdata[15:0] = 16'h3D7C;
		0299:	romdata[15:0] = 16'h0F00;
		0300:	romdata[15:0] = 16'h0180;
		0301:	romdata[15:0] = 16'h41F9;
		0302:	romdata[15:0] = 16'h0000;
		0303:	romdata[15:0] = 16'h04B0;
		0304:	romdata[15:0] = 16'h6100;
		0305:	romdata[15:0] = 16'h00D6;
		0306:	romdata[15:0] = 16'h3007;
		0307:	romdata[15:0] = 16'h6100;
		0308:	romdata[15:0] = 16'h0054;
		0309:	romdata[15:0] = 16'h6000;
		0310:	romdata[15:0] = 16'hFFFE;
		0311:	romdata[15:0] = 16'h3D7C;
		0312:	romdata[15:0] = 16'h0F00;
		0313:	romdata[15:0] = 16'h0180;
		0314:	romdata[15:0] = 16'h41F9;
		0315:	romdata[15:0] = 16'h0000;
		0316:	romdata[15:0] = 16'h0494;
		0317:	romdata[15:0] = 16'h6100;
		0318:	romdata[15:0] = 16'h00BC;
		0319:	romdata[15:0] = 16'h6000;
		0320:	romdata[15:0] = 16'hFFEA;
		0321:	romdata[15:0] = 16'h6000;
		0322:	romdata[15:0] = 16'hFEBE;
		0323:	romdata[15:0] = 16'h3D7C;
		0324:	romdata[15:0] = 16'h0002;
		0325:	romdata[15:0] = 16'h009C;
		0326:	romdata[15:0] = 16'h207C;
		0327:	romdata[15:0] = 16'h0000;
		0328:	romdata[15:0] = 16'h4000;
		0329:	romdata[15:0] = 16'h2D48;
		0330:	romdata[15:0] = 16'h0020;
		0331:	romdata[15:0] = 16'hE248;
		0332:	romdata[15:0] = 16'h0040;
		0333:	romdata[15:0] = 16'h8000;
		0334:	romdata[15:0] = 16'h3D40;
		0335:	romdata[15:0] = 16'h0024;
		0336:	romdata[15:0] = 16'h3D40;
		0337:	romdata[15:0] = 16'h0024;
		0338:	romdata[15:0] = 16'h302E;
		0339:	romdata[15:0] = 16'h001E;
		0340:	romdata[15:0] = 16'h0800;
		0341:	romdata[15:0] = 16'h0001;
		0342:	romdata[15:0] = 16'h6700;
		0343:	romdata[15:0] = 16'hFFF6;
		0344:	romdata[15:0] = 16'h4E75;
		0345:	romdata[15:0] = 16'h4840;
		0346:	romdata[15:0] = 16'h6100;
		0347:	romdata[15:0] = 16'h0006;
		0348:	romdata[15:0] = 16'h4841;
		0349:	romdata[15:0] = 16'h2001;
		0350:	romdata[15:0] = 16'hE058;
		0351:	romdata[15:0] = 16'h6100;
		0352:	romdata[15:0] = 16'h0006;
		0353:	romdata[15:0] = 16'h2001;
		0354:	romdata[15:0] = 16'hE058;
		0355:	romdata[15:0] = 16'h2200;
		0356:	romdata[15:0] = 16'hE808;
		0357:	romdata[15:0] = 16'h6100;
		0358:	romdata[15:0] = 16'h0008;
		0359:	romdata[15:0] = 16'h2001;
		0360:	romdata[15:0] = 16'h0200;
		0361:	romdata[15:0] = 16'h000F;
		0362:	romdata[15:0] = 16'h0600;
		0363:	romdata[15:0] = 16'h0030;
		0364:	romdata[15:0] = 16'h0C00;
		0365:	romdata[15:0] = 16'h0039;
		0366:	romdata[15:0] = 16'h6F00;
		0367:	romdata[15:0] = 16'h0006;
		0368:	romdata[15:0] = 16'h0600;
		0369:	romdata[15:0] = 16'h0007;
		0370:	romdata[15:0] = 16'h224B;
		0371:	romdata[15:0] = 16'h47EB;
		0372:	romdata[15:0] = 16'h0001;
		0373:	romdata[15:0] = 16'h0C00;
		0374:	romdata[15:0] = 16'h000A;
		0375:	romdata[15:0] = 16'h660C;
		0376:	romdata[15:0] = 16'h96C2;
		0377:	romdata[15:0] = 16'h343C;
		0378:	romdata[15:0] = 16'h0000;
		0379:	romdata[15:0] = 16'h47EB;
		0380:	romdata[15:0] = 16'h027F;
		0381:	romdata[15:0] = 16'h602A;
		0382:	romdata[15:0] = 16'h4880;
		0383:	romdata[15:0] = 16'h0440;
		0384:	romdata[15:0] = 16'h0020;
		0385:	romdata[15:0] = 16'hE740;
		0386:	romdata[15:0] = 16'h41F9;
		0387:	romdata[15:0] = 16'h0000;
		0388:	romdata[15:0] = 16'h04C4;
		0389:	romdata[15:0] = 16'hD0C0;
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
		1020:	romdata[15:0] = 16'h0000;
		1021:	romdata[15:0] = 16'h0000;
		1022:	romdata[15:0] = 16'h0000;
		1023:	romdata[15:0] = 16'h0000;
	endcase
end

// output enable
always @(romdata or aen or rd)
	if (aen && rd)
		data_out[15:0] = romdata[15:0];
	else
		data_out[15:0] = 16'h0000;

endmodule
